Okaymario268/Futuro-Ing-2026/schemes/README.md

# Schemes — electromechanical & wiring schematics

Schematic diagrams (JPEG, PNG or PDF) of every electronic component and motor in
the vehicle and how they connect:

- Arduino UNO Q wiring
- MPU-6050 (GY-521) on I2C (A4/A5)
- Steering servo on D9
- DC drive motor via the L298N driver
- Power distribution (12 V battery)
- LM2596
- Logitech Brio 300
- Ultrasonic
- L298n
