Okaymario268/Futuro-Ing-2026/other/README.md

# Other — engineering documentation

Supporting documentation, build notes and the project website.

## Documents

- [`fabrication-challenges.md`](fabrication-challenges.md) — problems faced during
  development (Raspberry Pi first version), the move to the Arduino UNO Q, and the
  servo calibration via the HTML web UI.
- [`docs/`](docs/) — the project website (HTML + CSS, for GitHub Pages).
