Okaymario268/Futuro-Ing-2026/v-photos/README.md

# Vehicle photos

Photos of the vehicle from every side — front, back, left, right, top and bottom —
as required by the WRO Future Engineers engineering-materials template.
