Okaymario268/Futuro-Ing-2026/video/video.md

# Driving demonstration video

**Open Challenge (Stage 1):** https://www.youtube.com/shorts/cSLZId9H9bs

A raw recording (`iPhone.mp4`) is also included in this folder.
