Okaymario268/Futuro-Ing-2026/images/README.md

# Images

Branding and reference images used by the README and the website.

- `panama-flag.png` — flag of Panamá used in the headers
- `components/` — product photos of the vehicle's components
