Okaymario268/Futuro-Ing-2026/images/placeholders/Screenshot 2026-07-13 204531.png

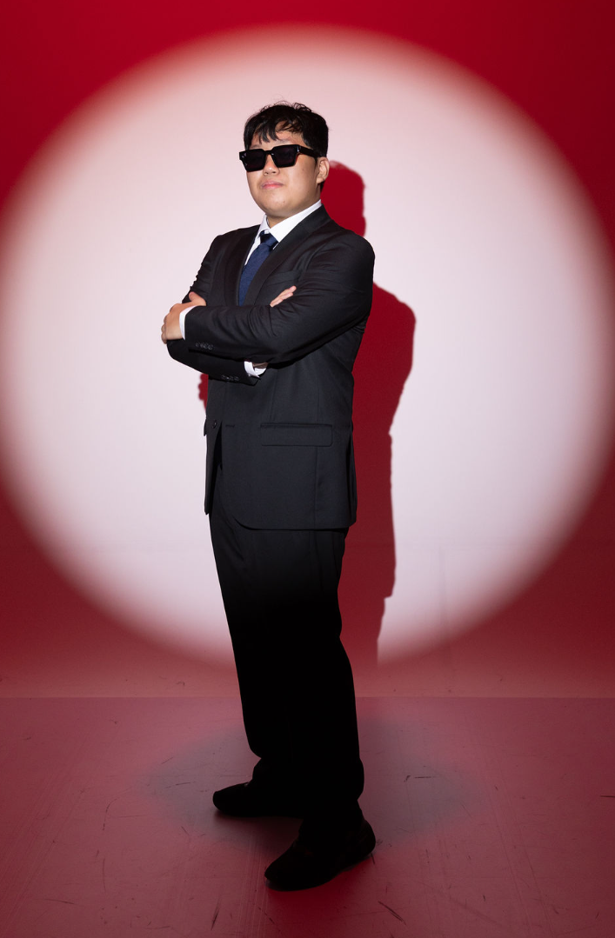
images/placeholders/Screenshot 2026-07-13 204531.png
