Okaymario268/Futuro-Ing-2026/v-photos/back.jpeg

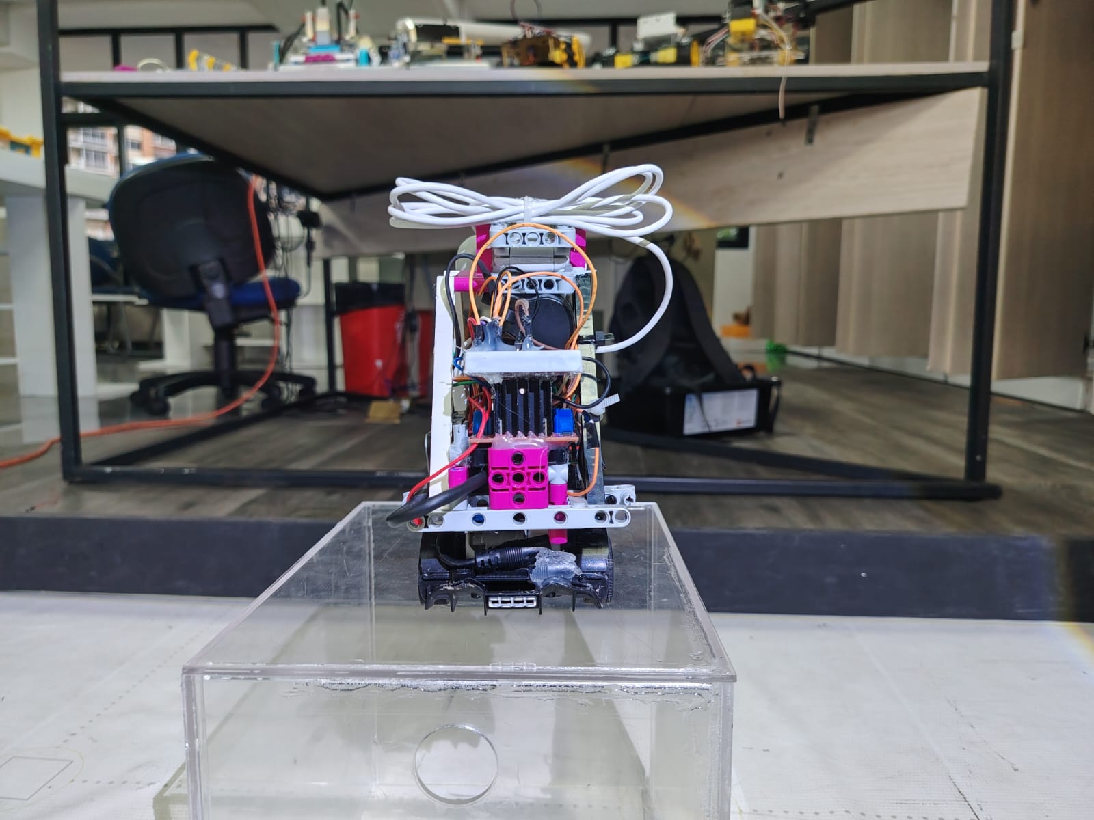
v-photos/back.jpeg
