Okaymario268/Futuro-Ing-2026/v-photos/bottom.jpeg

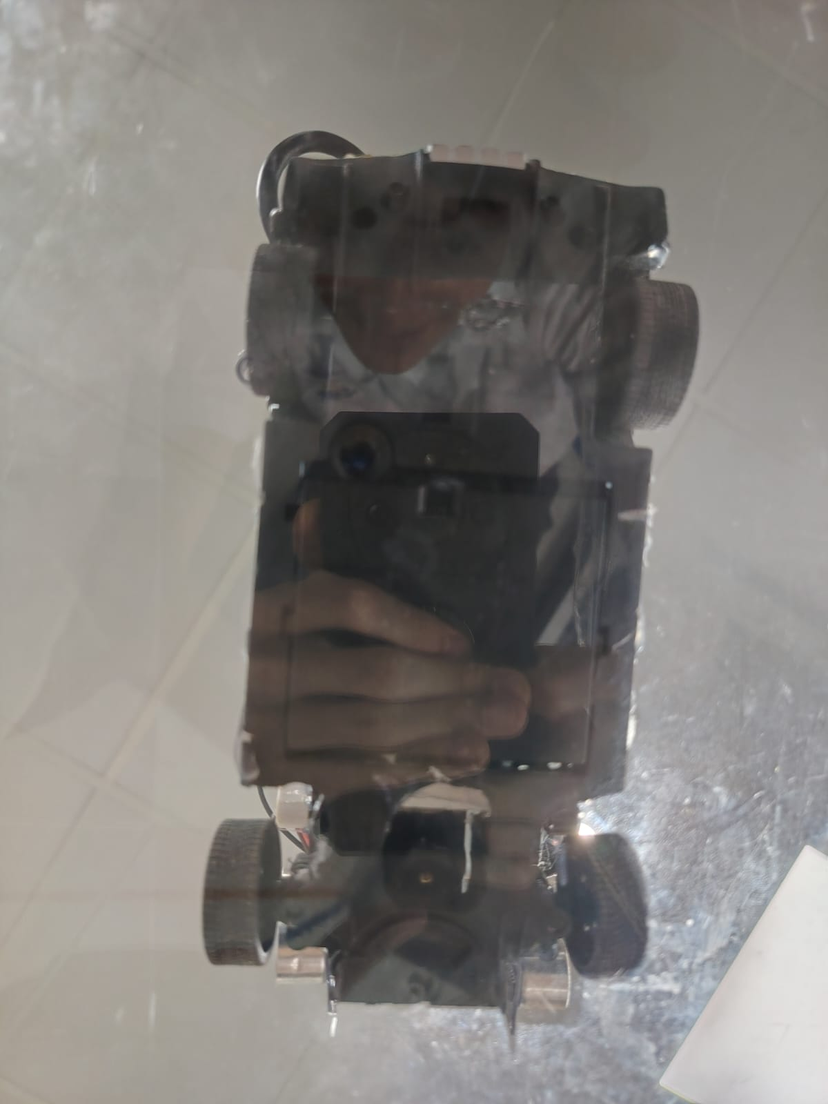
v-photos/bottom.jpeg
