Okaymario268/Futuro-Ing-2026/v-photos/front.jpeg

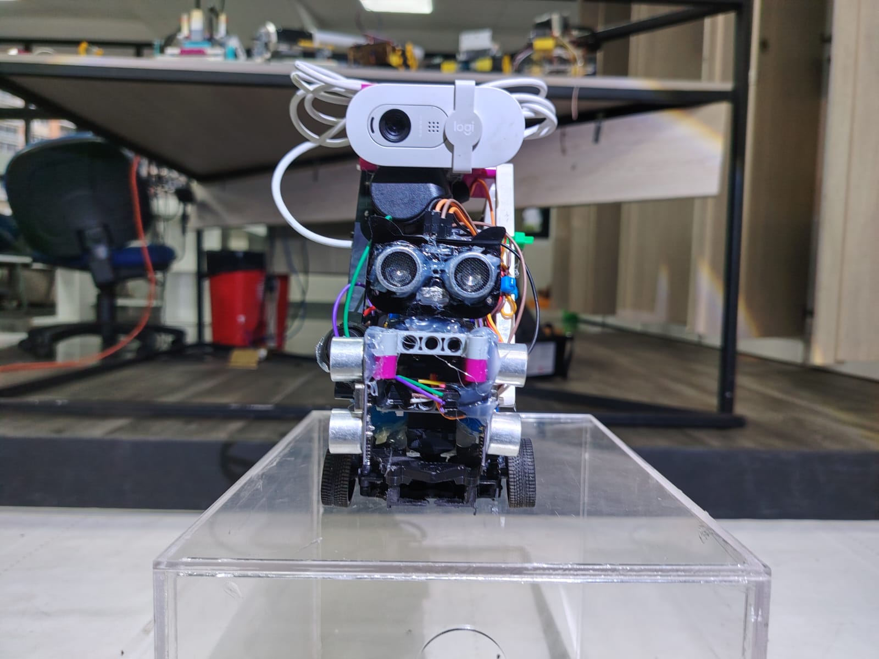
v-photos/front.jpeg
