Okaymario268/Futuro-Ing-2026/v-photos/left.jpeg

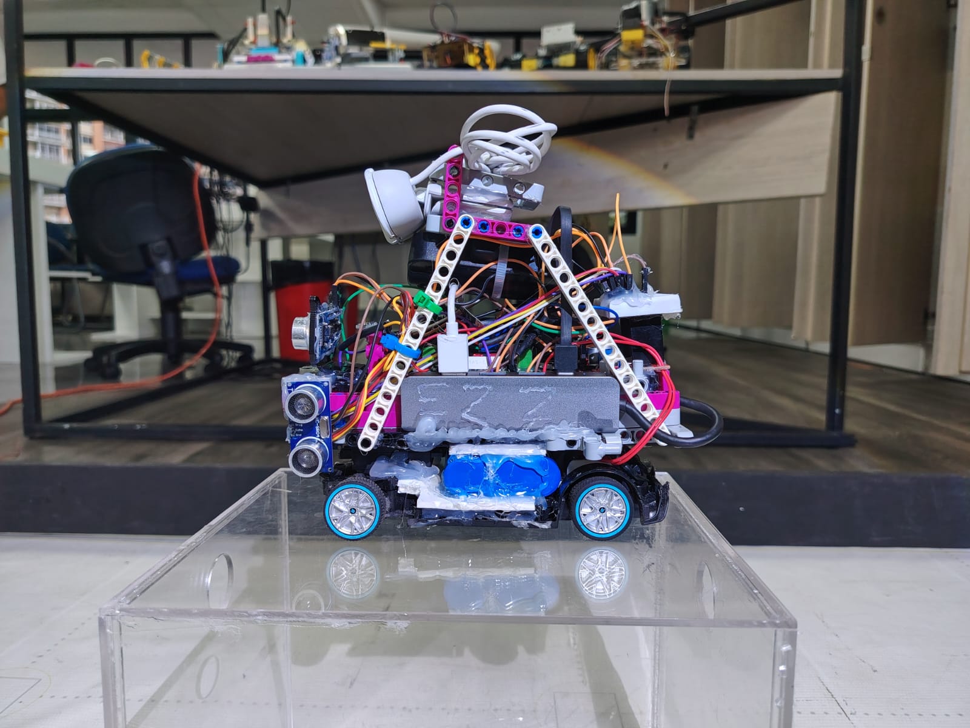
v-photos/left.jpeg
