Okaymario268/Futuro-Ing-2026/v-photos/right.jpeg

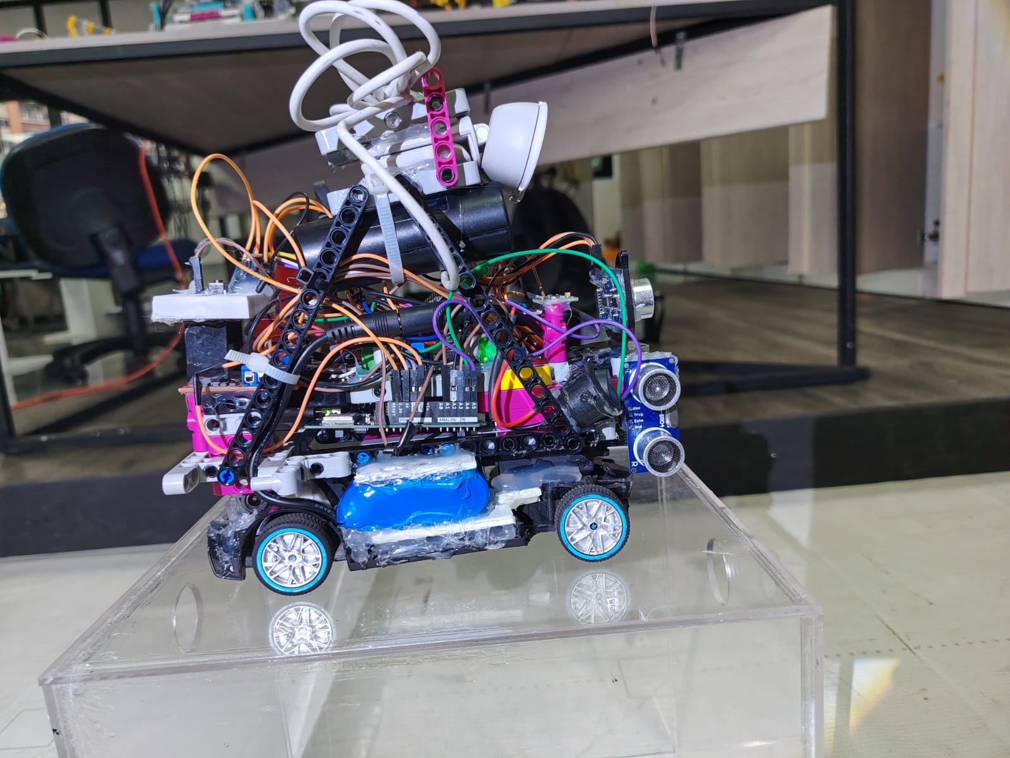
v-photos/right.jpeg
