Okaymario268/Futuro-Ing-2026/v-photos/top.jpeg

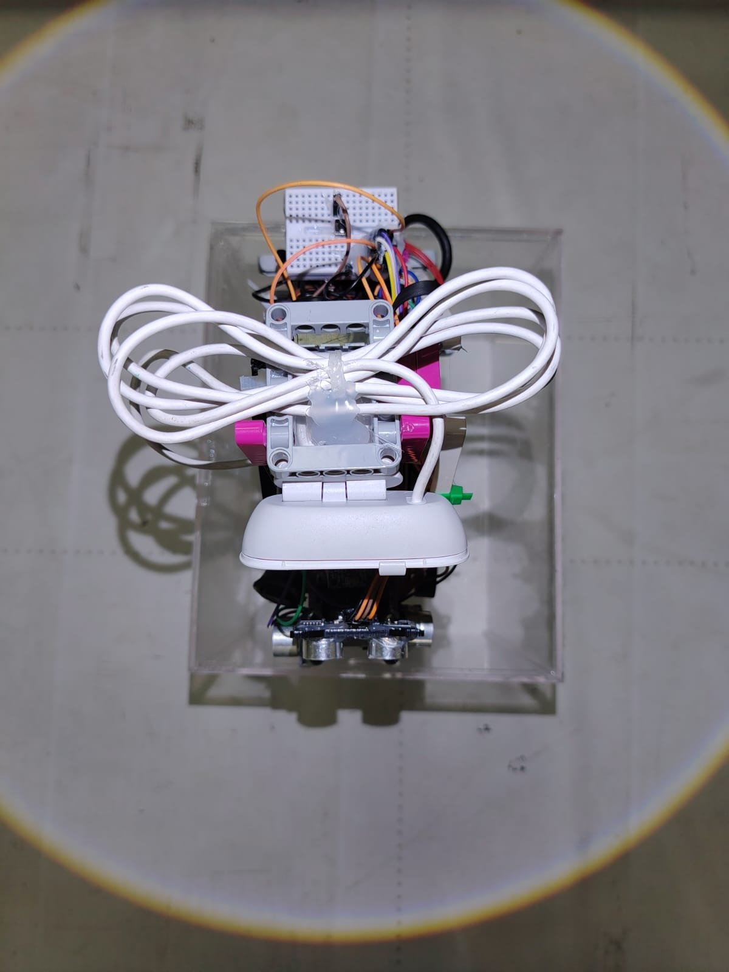
v-photos/top.jpeg
