Okaymario268/Futuro-Ing-2026/images/components/README.md

# Component photos

Product photos of the vehicle's components, shown as thumbnails in the README
**Materials** table.

| File | Component |
|---|---|
| `arduino-uno-q.webp` | Arduino UNO Q |
| `l298n.png` | L298N motor driver |
| `dc-motor.png` | DC drive motor |
| `servo.png` | Steering servo |
| `gy-521.jpeg` | GY-521 (MPU-6050) gyroscope |
| `camera.jpg` | Logitech camera |
| `battery.png` | 12 V 3S 18650 battery |
| `jumpers.png` | Jumper cables |
