Okaymario268/Futuro-Ing-2026/images/components/hub.jpg

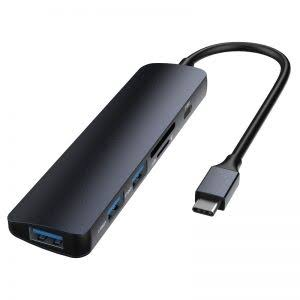
images/components/hub.jpg
