Okaymario268/Futuro-Ing-2026/images/components/l298n.png

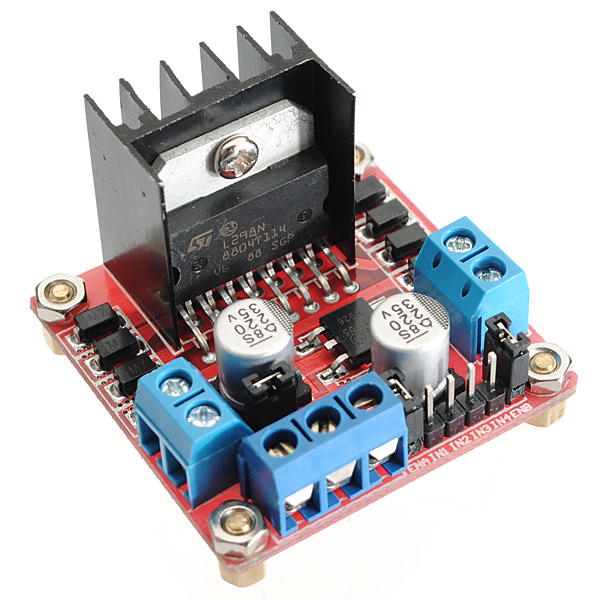
images/components/l298n.png
