Okaymario268/Futuro-Ing-2026/images/components/LM2596.jpg

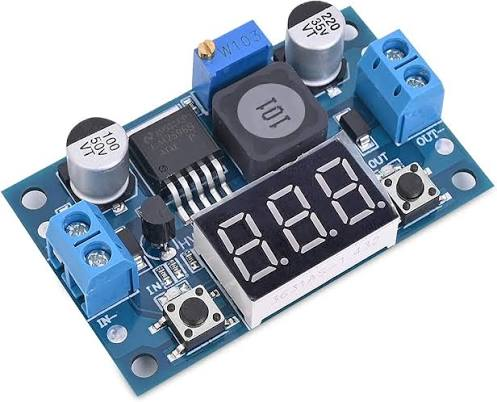
images/components/LM2596.jpg
