Okaymario268/Futuro-Ing-2026/images/components/ultrasonic.jpg

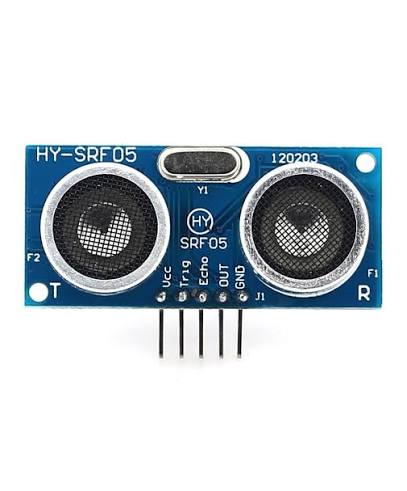
images/components/ultrasonic.jpg
