Okaymario268/Futuro-Ing-2026/schemes/wiring.png

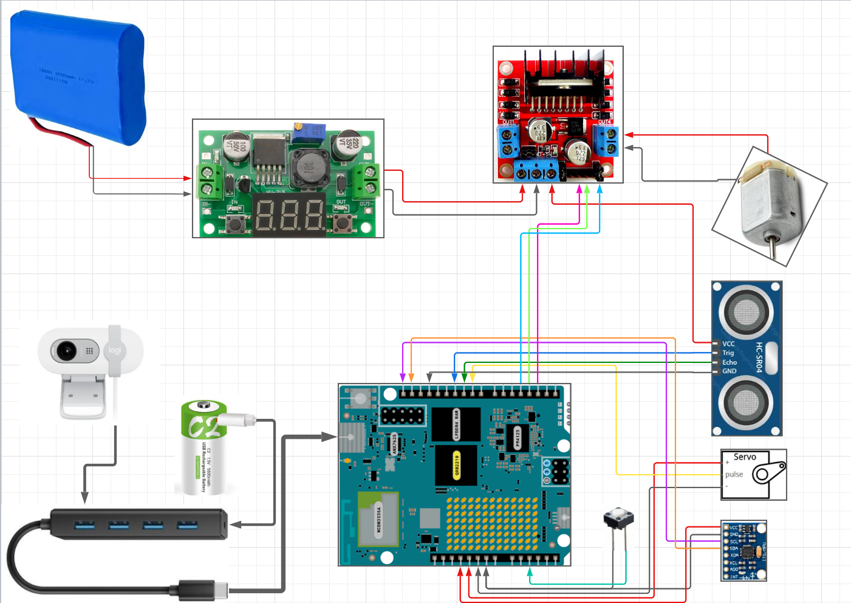
schemes/wiring.png
