Okaymario268/Futuro-Ing-2026/src/python/stage2_obstacle.py

"""stage2_obstacle.py — WRO Future Engineers · STAGE 2 · OBSTACLE CHALLENGE entry point.

Everything Stage 1 does (3 laps, orange/blue corners, direction latch, 12-corner count)
PLUS the two Stage-2-only behaviours:
  * red/green pillar passing  — produced in vision.py `decide_obstacle` (red on the
    RIGHT, green on the LEFT) and applied through the same `nudge` bias channel.
  * parallel parking finish   — the reverse-arc maneuver below, fired after corner #12.

Select this file as the App Lab program for an Obstacle-Challenge round.

    Camera (vision, stage="obstacle") --> RaceController (fsm) --> bridge_io --> MCU

>>> IMPORTANT (from the verified brief) <<<
This robot has only a camera + gyro — no side distance sensor. Dead-reckoned parking
is the documented failure mode (drift can clip a magenta marker -> ZERO parking points).
The sequence below is a tunable STARTING FRAMEWORK; strongly consider adding one
side-facing ToF/ultrasonic sensor to localise the slot opening and the rear wall.
All angles/speeds/durations are starting points to tune on the real mat.

Every variable and function of the app is documented in src/DOCUMENTATION.txt.
"""
import threading
import time

from arduino.app_utils import App

from vision import VisionPipeline
from fsm import RaceController
import bridge_io as io

# ===========================================================================
# BOT CONFIGURATION — every knob of THIS file lives here, first lines of code.
# (Race tuning is at the top of fsm.py, camera tuning at the top of vision.py,
#  MCU pins/speeds at the top of sketch/sketch.ino — see src/DOCUMENTATION.txt)
# ===========================================================================

# ---- Start gate --------------------------------------------------------------------
USE_START_BUTTON = True   # True  = wait for the physical START button + 3-2-1 countdown
                          #         on the LED matrix (WRO rule 9.6 competition start).
                          # False = auto-start START_DELAY_S after launch (bench tests).
START_DELAY_S    = 2.0    # s before auto-start (used only when USE_START_BUTTON is False)

# ---- Parallel-park (reverse-arc) tuning — Stage 2 only ------------------------------
PARK_SPEED   = 45    # % drive speed during the maneuver (slow + controlled)
ENTRY_ANGLE  = 75    # deg: swing the tail toward the curb/slot
STRAIGHTEN   = 70    # deg: counter-steer back toward the lane while still reversing
TUCK         = 5     # deg: small forward nudge to kill residual angle (<=2 cm parallel tol)
SEG_TIMEOUT  = 4.0   # s: per-segment safety timeout waiting for the heading target


def _wait_target(timeout=SEG_TIMEOUT):
    """Block until the MCU reports the heading is within tolerance of its target."""
    t0 = time.time()
    while not io.at_target() and (time.time() - t0) < timeout:
        time.sleep(0.05)


def parallel_park(direction):
    """Reverse-arc parallel park. `direction` is the latched lap turn sign (+90 CW / -90 CCW);
    `s` mirrors the maneuver for the slot side. VERIFY the side on your mat and flip if needed."""
    s = 1 if direction >= 0 else -1
    print(f"[park] start (direction={direction}, s={s})", flush=True)

    io.set_speed(PARK_SPEED)
    io.set_drive_dir(-1)                 # reverse
    io.turn(-ENTRY_ANGLE * s)            # 1) swing tail into the slot
    _wait_target()
    io.turn(+STRAIGHTEN * s)             # 2) counter-steer straight, still reversing
    _wait_target()
    io.set_drive_dir(+1)                 # 3) small forward tuck to remove residual angle
    io.turn(+TUCK * s)
    _wait_target()
    io.set_speed(0)
    io.set_drive_dir(+1)
    print("[park] done", flush=True)


# --- Standalone entry point --------------------------------------------------
# Only runs when this file IS the App Lab program (swapped in as main.py). When
# main.py imports parallel_park for its in-UI launcher, __name__ != "__main__",
# so nothing below runs (no double camera / double App.run()).
if __name__ == "__main__":
    controller = RaceController(stage="obstacle", on_park=parallel_park)
    camera = VisionPipeline(stage="obstacle", on_command=controller.on_vision)
    controller.pipeline = camera   # keeps the shared direction latch in step

    def _begin():
        """Release the run: honour the start gate (physical button + countdown on
        the MCU) or the plain bench timer, then put the race controller in DRIVE."""
        io.set_start_button(USE_START_BUTTON)     # sync the toggle to the MCU + arm the gate
        if USE_START_BUTTON:
            print("[obstacle] armed — press the START button (3-2-1 on the LED matrix)...", flush=True)
            while not io.start_ready():
                time.sleep(0.05)
        else:
            time.sleep(START_DELAY_S)
        controller.start()

    print("[obstacle] Stage 2 — Obstacle Challenge: starting camera + run", flush=True)
    io.start_heartbeat()   # MCU stops the motor if this program dies mid-run
    camera.start()
    threading.Thread(target=_begin, daemon=True).start()

    App.run()
