Okaymario268/Futuro-Ing-2026/(commit log)

2026-05-18 Motor funcionando
2026-05-25 Servo motor calibration first test
2026-05-25 Servo calibration 2
2026-06-29 Add Bill of Materials section to README
2026-06-29 Add GitHub Pages site (docs/) with CSS styling — Robotech La Salle
2026-06-29 Remove models section; add DC motor & servo to materials; scaffold component photos
2026-06-29 Add fabrication-challenges doc (Raspberry Pi problems -> UNO Q) in other/
2026-06-29 Document servo calibration via HTML web UI (center = 79 deg)
2026-06-29 Vehicle control software (Arduino sketch + Python Web UI)
2026-06-29 Electromechanical and wiring schematics
2026-06-29 Add researched Materials & Specifications (README + site mirror with key specs)
2026-06-29 Stage-separated autonomous code: Open (stage1) + Obstacle (stage2) over shared vision/fsm/bridge + MCU reverse/lap RPCs
    [bridge_io.py, fsm.py, sketch.ino, stage1_open.py, stage2_obstacle.py, vision.py]
2026-06-29 Add component photos to images/components/ and wire thumbnails into README BOM
2026-07-14 Side ultrasonics own the Stage-1 corridor: centering + corners in both directions; restore 3-lap stop
    Brings main's src/ current with the robot (includes the review-hardening and HC-SR04 front-ranger/start-gate work from test-laser-hw843, plus today's gg15 changes).
    - sketch.ino: LEFT (TRIG D5/ECHO D6) + RIGHT (TRIG A2/ECHO A3) HC-SR04 side rangers, polled non-blocking with median-of-3; RPCs get_left_mm/get_right_mm/get_gyro_ok (I2C health). A4/A5 stay gyro-only: the left sensor wired there clamped SCL and killed heading-hold in BOTH directions.
    - fsm.py: TOTAL_CORNERS 16->12 (the never-stops-after-3-laps bug); ranger corner trigger (front close + inside open, direction-agnostic) merged wit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
    [bridge_io.py, fsm.py, main.py, sketch.ino, stage1_open.py, stage2_obstacle.py]
2026-07-14 Replace README placeholders with real vehicle photos and wiring diagram
    - Vehicle Gallery: swap placeholder SVGs for real v-photos (front/back/left/right/top/bottom)
    - Wiring: add schemes/wiring.png and reference it in the Wiring section
    - v-photos: rename botton.jpeg -> bottom.jpeg, drop stray photo.zip
    - Team: remove member placeholders and placeholder-related notes
2026-09-09 Update to Modulino Hub ecosystem + MPU-6050 on Wire1 + LD19 lidar
    Migrates from the L298N + HC-SR04 + bare MPU-6050 build to Modulino Hub/
    Distance x3/Buttons/Motors, keeps the same MPU-6050 gyro now soldered to
    the Hub's Wire1 pass-through pads, and adds an LDROBOT LD19 lidar plus a
    colour-line camera backup for corner detection.
    - src/sketch/sketch.ino, src/python/main.py (+lidar_ld19.py), app.yaml,
    sketch.yaml, assets/: updated to the real, currently-flashed program.
    - README.md: updated overview, module map, materials table (new Modulino
    + lidar images), wiring table, and UNO Q gotchas (Wire vs Wire1 bug,
    I2C flooding bug).
    - other/fabrication-challenges.md: added Part 2 documenti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
